scottalmond/EletronicEgg/README.md

# EletronicEgg
No-mess eletronic solution to the classical egg drop contest

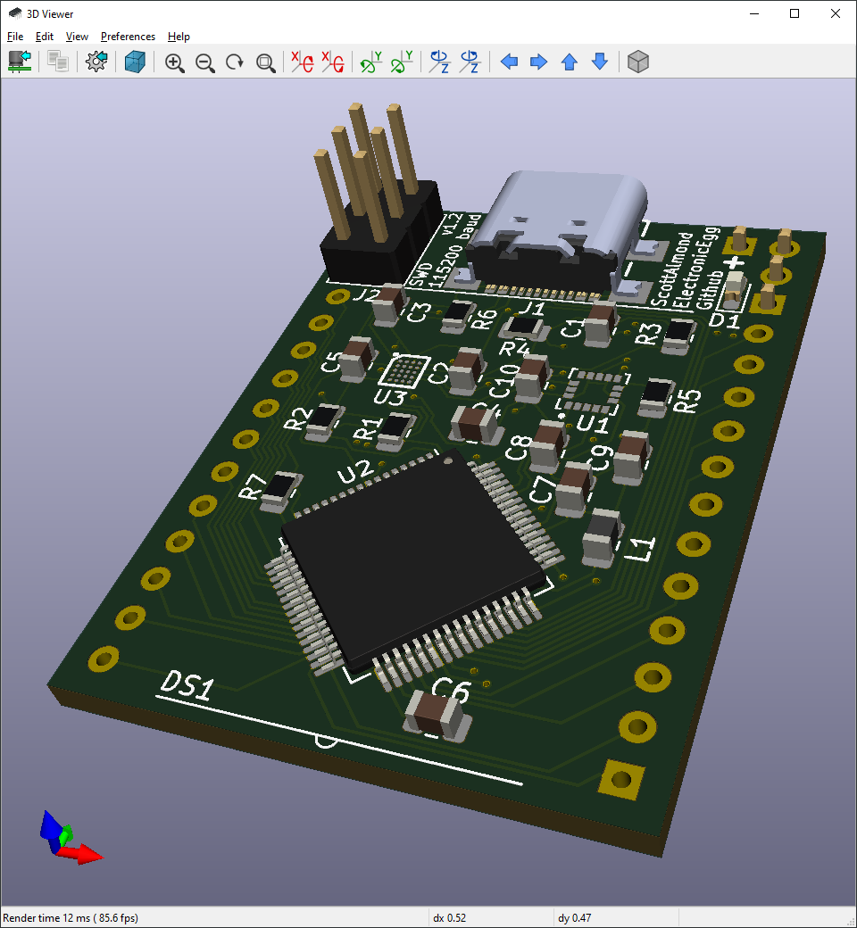
[picture p1: pcb/draft_1-2/png/3d_orthographic_front.png]
v1.1 Build
