scottalmond/EletronicEgg/pcb/draft_1-1/fab_notes.txt

set to 6mil spacing (default to 8)
set min hole size to 0.3mm since there was no impact on cost

as built list:
https://www.youtube.com/watch?v=ENmDnoKs2hM
plus F and B paste layers
$22.97 including shipping and PayPal fee

-- 1/6/20
as-delivered
width of 3-segment display is wrong, will need to bend all leads to fit
IS 22.86 mm (0.9")
***SHOULD BE just under 1.00" 

require stand-alone programming pins
https://www.avdweb.nl/arduino/samd21/samd21-programmer
***SHOULD BE ICE header
- pull-up on SWCLK pin 1k (10k?) [has internal pull-up at start-up per page 88 of SAML21 foc, 15.6.2]
https://learn.adafruit.com/programming-an-m0-using-an-arduino
- 100k on SWDIO https://www.microchip.com/webdoc/GUID-B2CE0E6C-70BF-42CF-B0CF-6705800FC877/index.html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

***consider through-hole 10k thermistor
***add /MR reset to allow toggle of 18.8V rail

1/12/19 lots of issues determining how to program SAML21 vs the ATTINY85 in the last project
need special debugger, beware educaton license limitations.  Was assuming everything could be done over USB - but only true after first flash

solder stencil tutorial https://www.meatandnetworking.com/tutorials/creating-svg-files-worth-of-creating-solder-stencils-from-kicad/

voltera stencil
https://www.voltera.io/docs/export/kicad/

***add compressed air and flux to parts list

***typo on "electronic" missing 'c'

- 1/16/20

need BOM print out for CCA fab, part placement
0402 heats up quickly during rework (bkth ends of part)
desire refactot with 0805 since 0402 are challenging to work with
not all parts (0805) lie perfectly flat
issue with gettting solder out of voltera for larger pcb pads (hot/dry solder?)
observe short (?) under usb header
PMIC has no bond (solder reflow point is higher than default Votera temperature)
reworked other issues by hand (incomplete passive bonding, SAML lead bridging)

- 1/17/20
***1.8V and 3.3V are shorted
***add test point for every voltage, i2c

***add place for debug led (no-pop in final model?)
