scottalmond/EletronicEgg/pcb/mockup_1-0/sketch.pdf

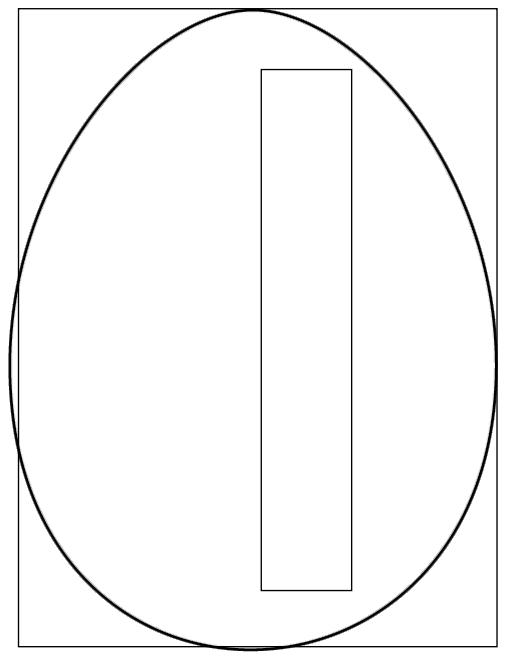
[picture p2: figure]
