scottalmond/EletronicEgg/pcb/draft_1-1/pcb/draft_1.png

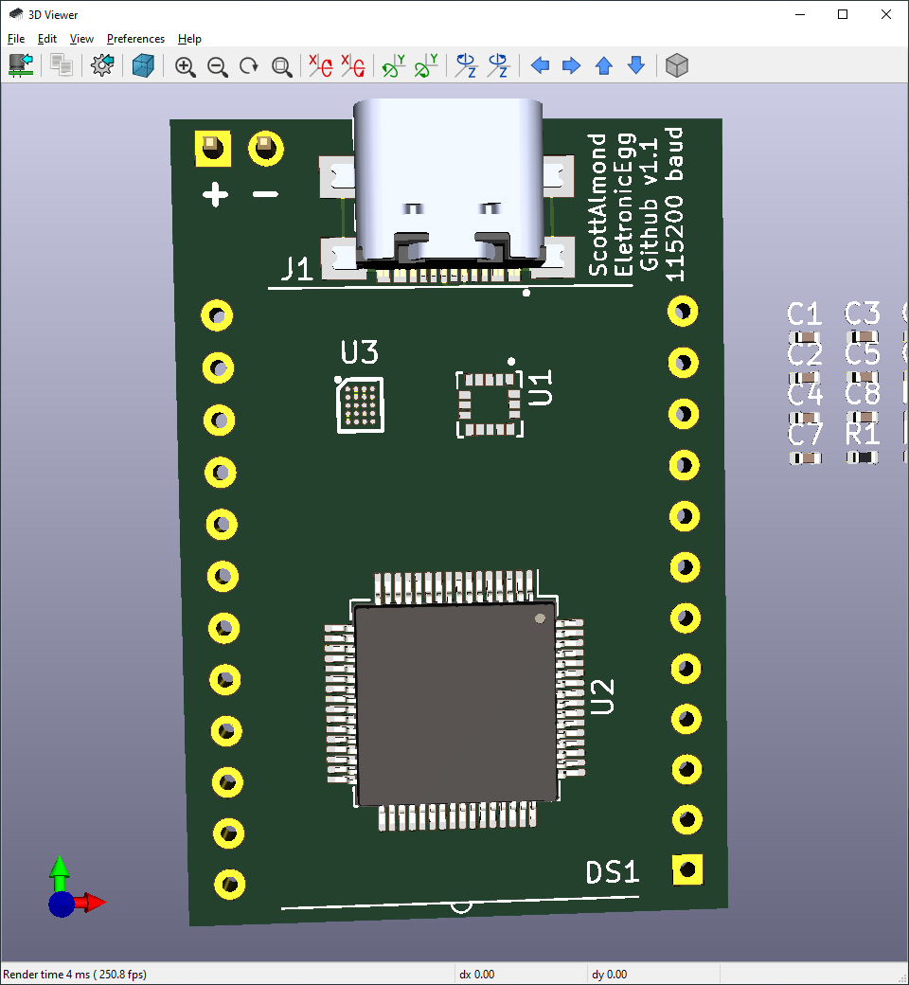
pcb/draft_1-1/pcb/draft_1.png
