scottalmond/EletronicEgg/pcb/draft_1-1/pcb/draft_1_sch.png

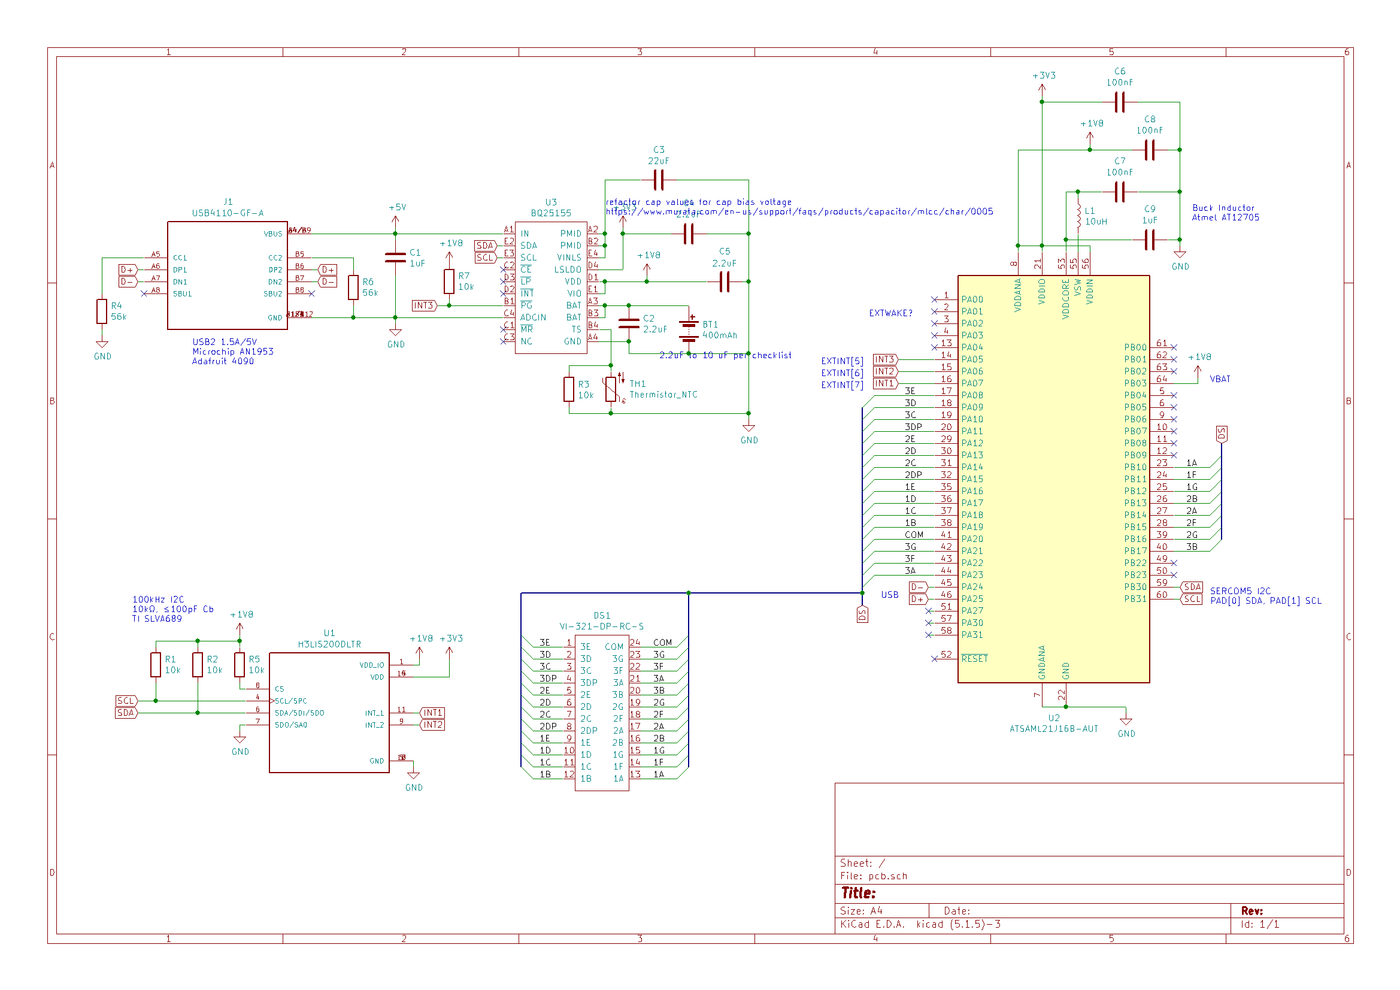
pcb/draft_1-1/pcb/draft_1_sch.png
