scottalmond/EletronicEgg/pcb/draft_1-1/png/001.png

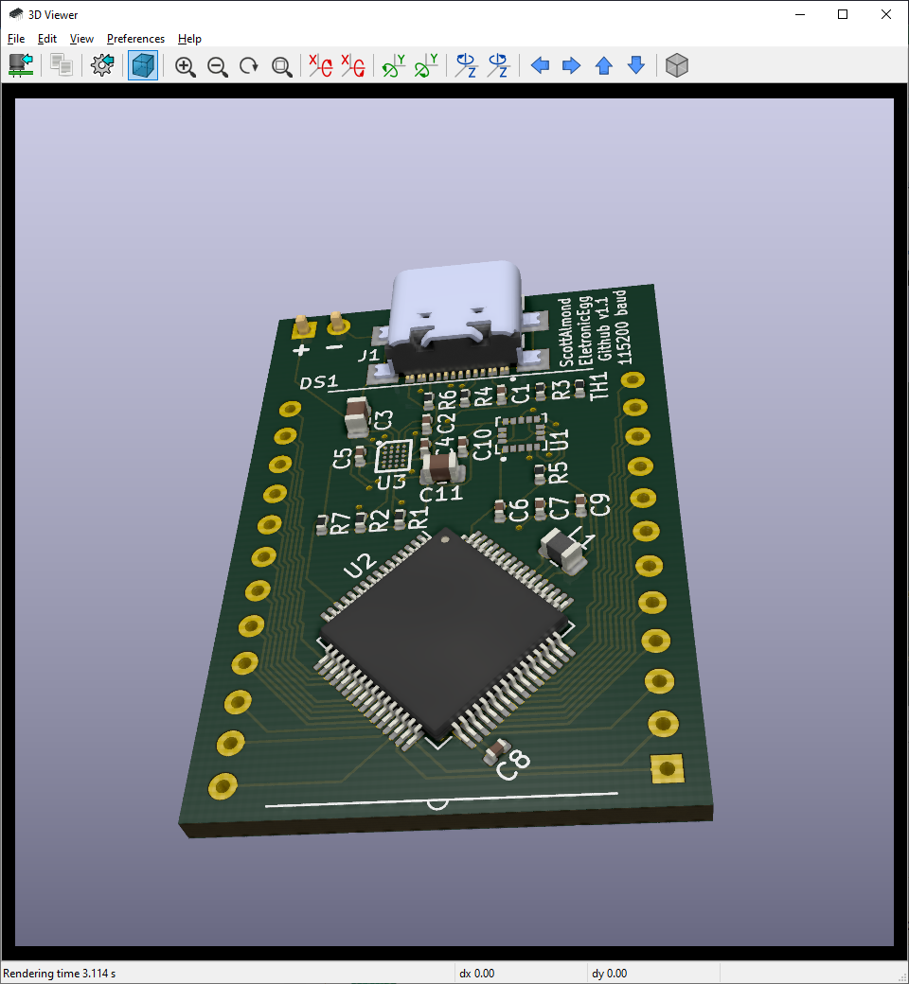
pcb/draft_1-1/png/001.png
