scottalmond/EletronicEgg/pcb/draft_1-1/png/002.png

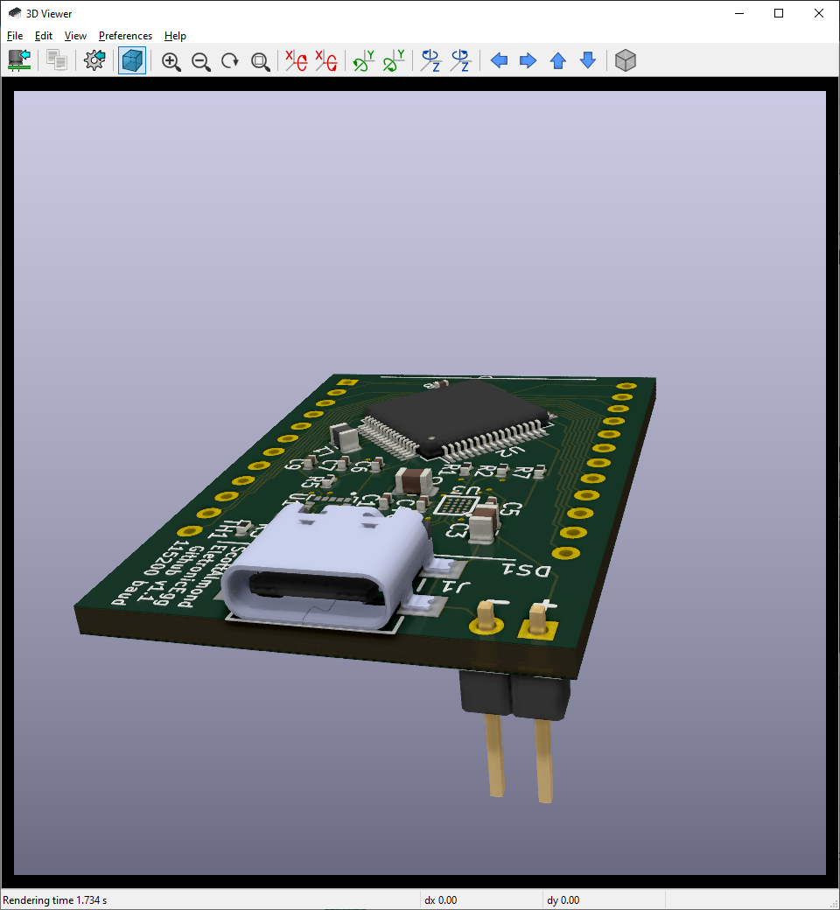
pcb/draft_1-1/png/002.png
