scottalmond/EletronicEgg/pcb/draft_1-1/png/back.png

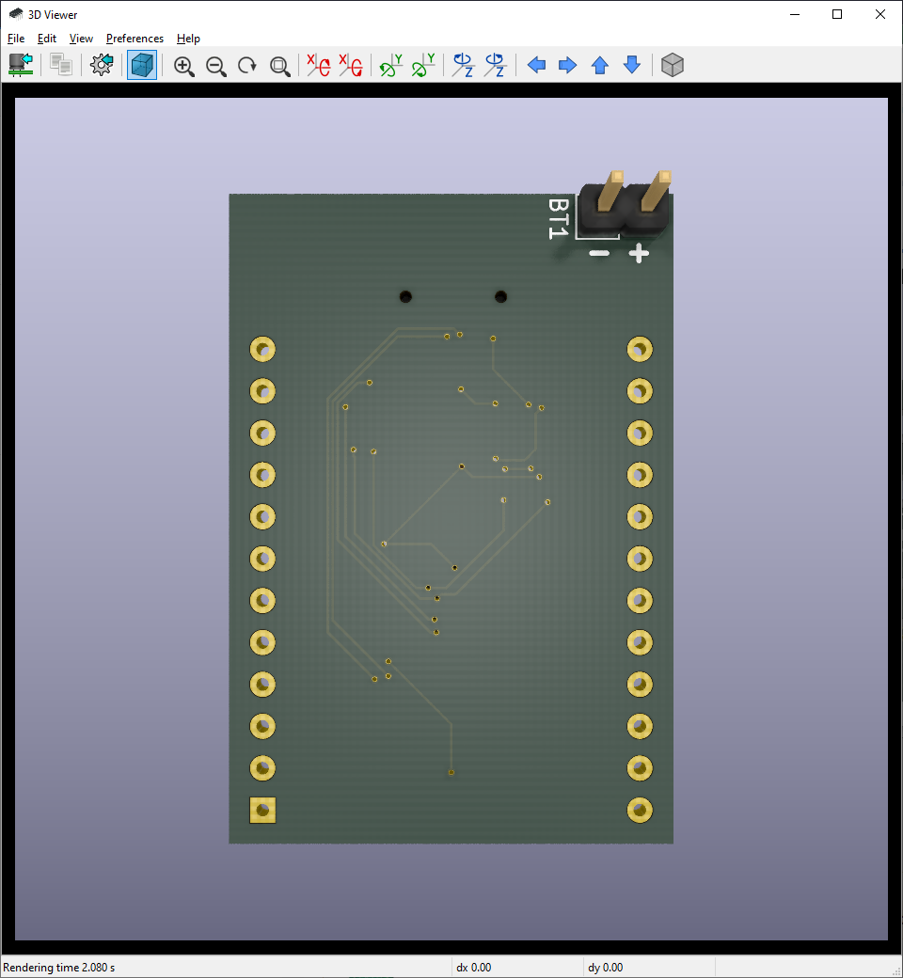
pcb/draft_1-1/png/back.png
