scottalmond/EletronicEgg/pcb/draft_1-1/png/pcbnew.png

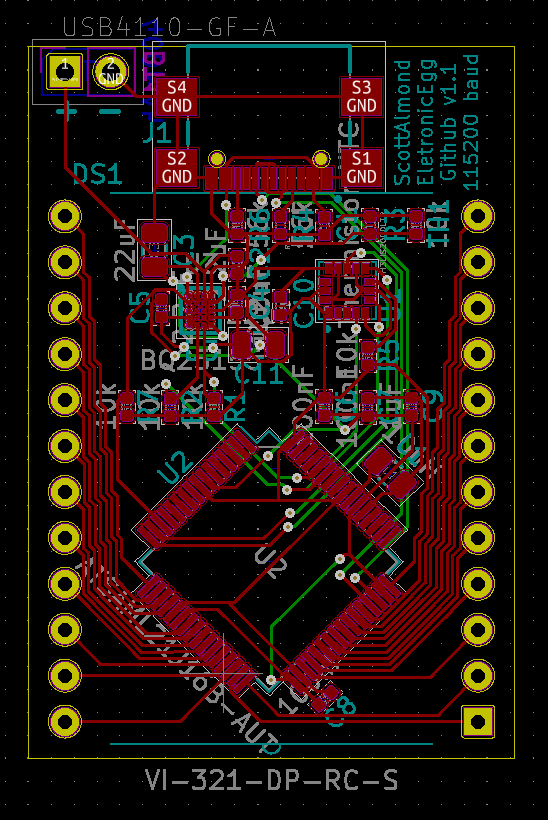
pcb/draft_1-1/png/pcbnew.png
