scottalmond/EletronicEgg/pcb/draft_1-1/png/schematic.png

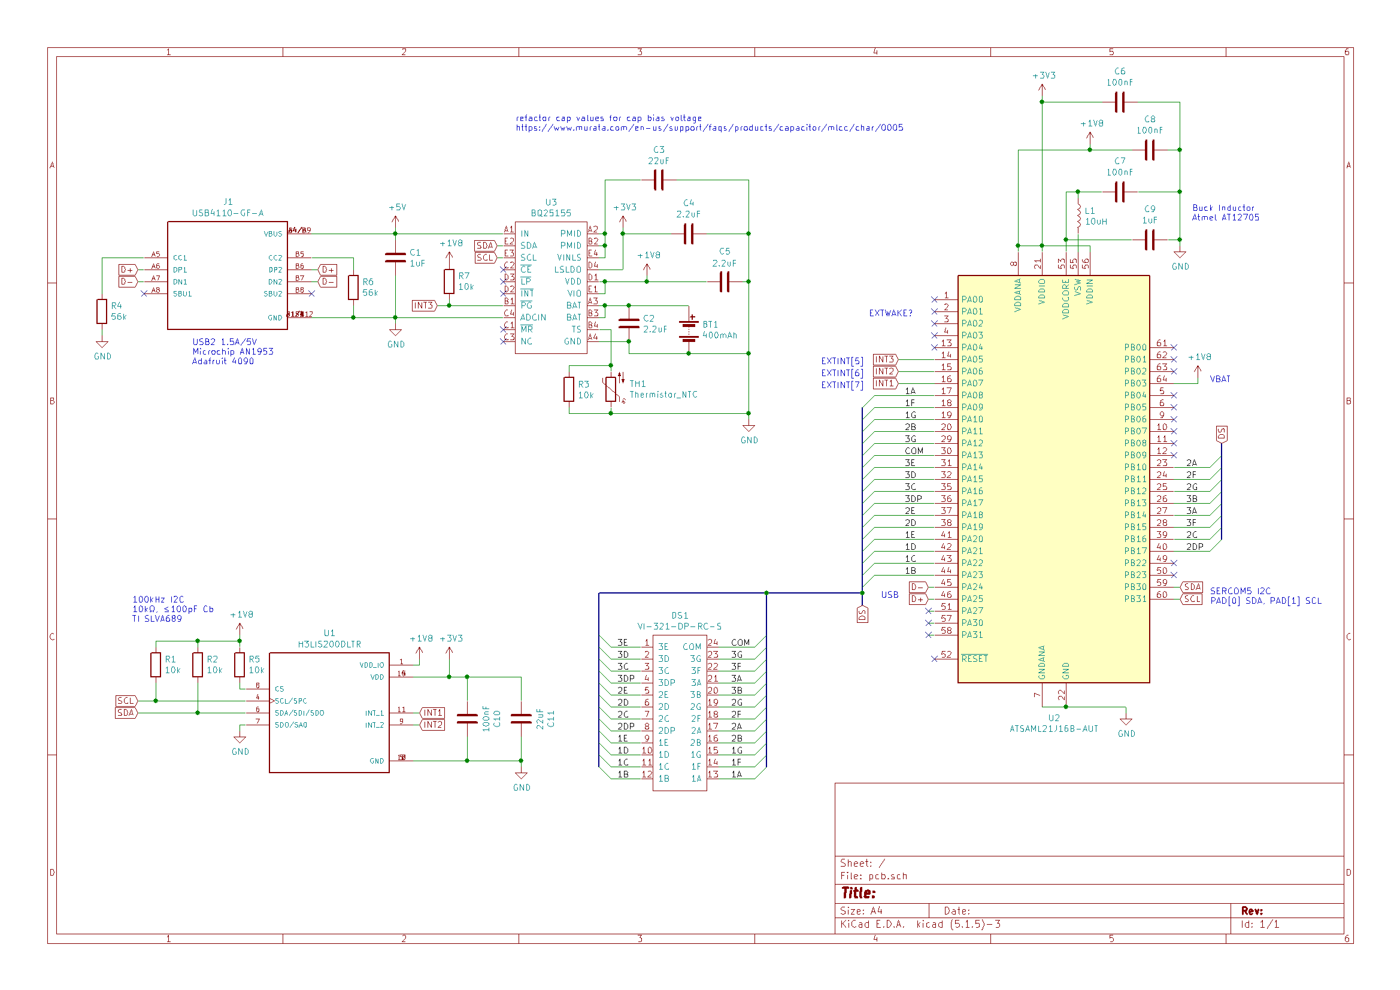
pcb/draft_1-1/png/schematic.png
