scottalmond/EletronicEgg/pcb/draft_1-1/png/top.png

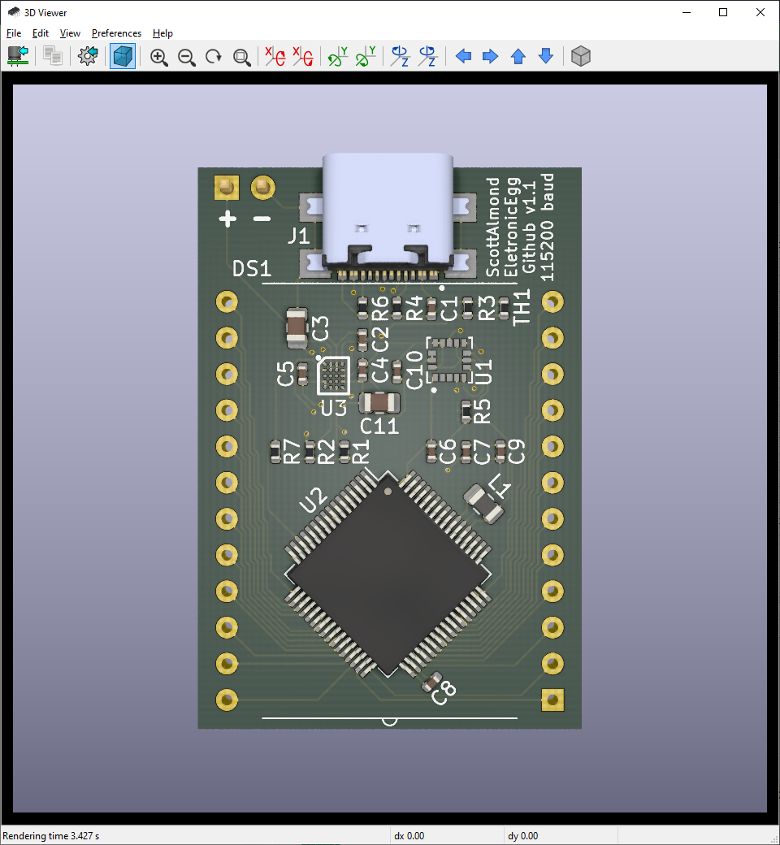
pcb/draft_1-1/png/top.png
