scottalmond/EletronicEgg/pcb/draft_1-2/png/3d_back.png

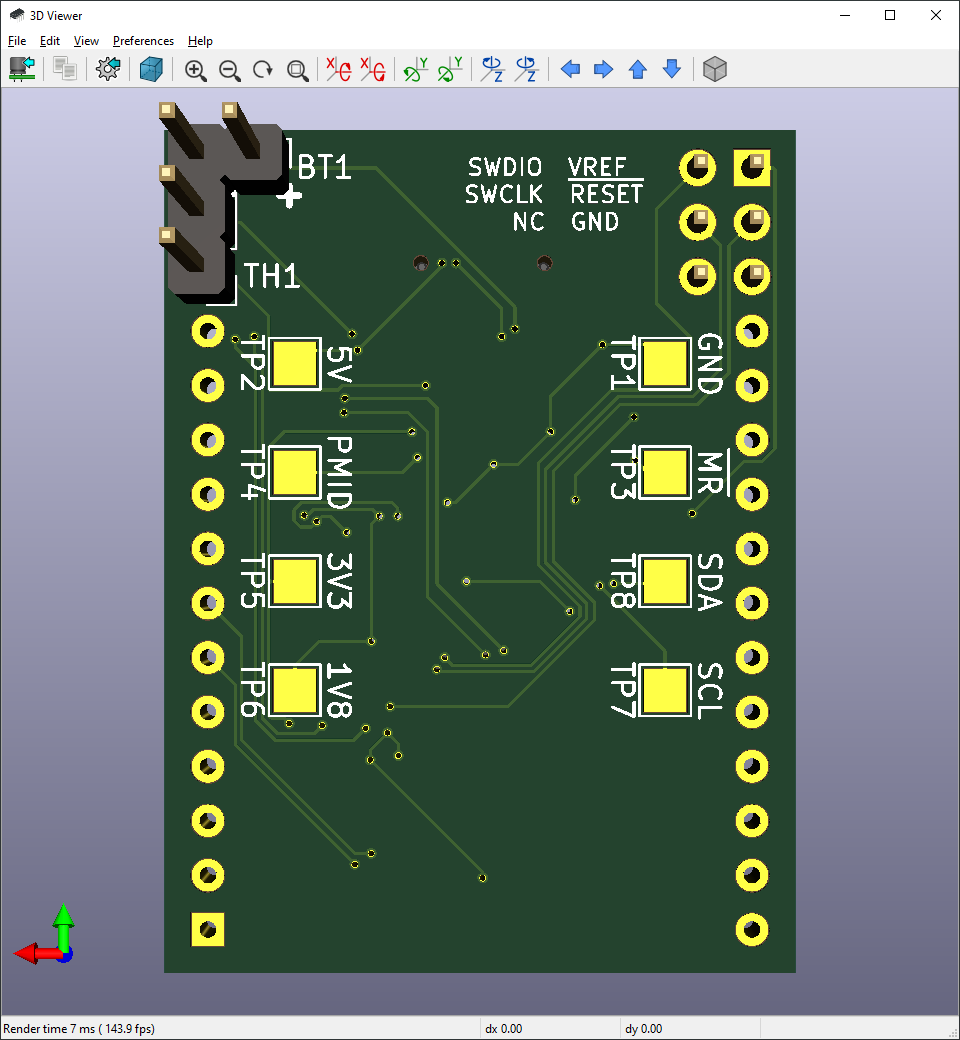
pcb/draft_1-2/png/3d_back.png
