scottalmond/EletronicEgg/pcb/draft_1-2/png/3d_front.png

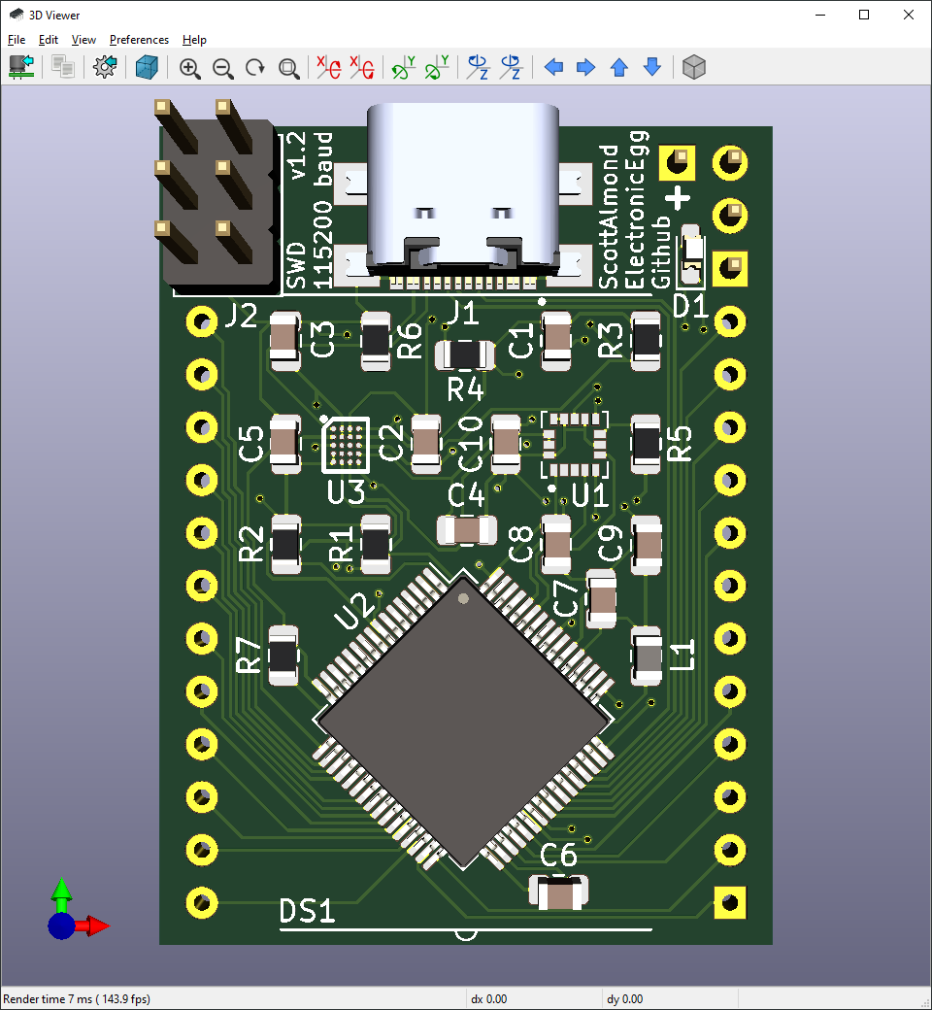
pcb/draft_1-2/png/3d_front.png
