scottalmond/EletronicEgg/pcb/draft_1-2/png/3d_orthographic_back.png

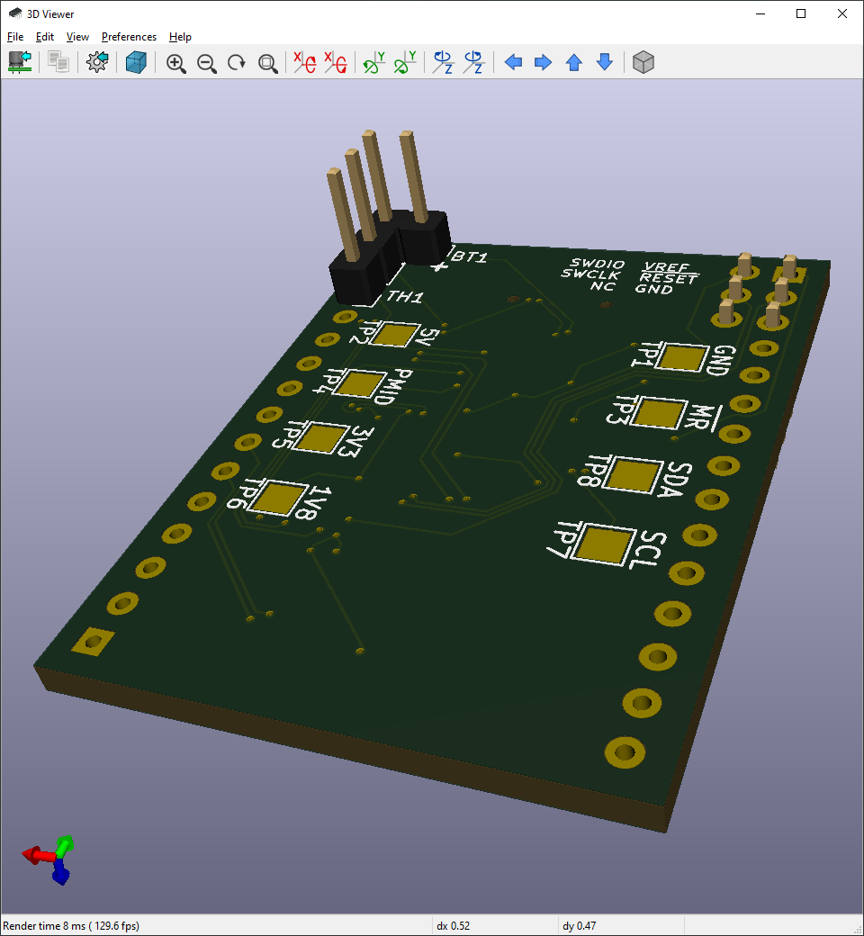
pcb/draft_1-2/png/3d_orthographic_back.png
