scottalmond/EletronicEgg/pcb/draft_1-2/png/pcb.png

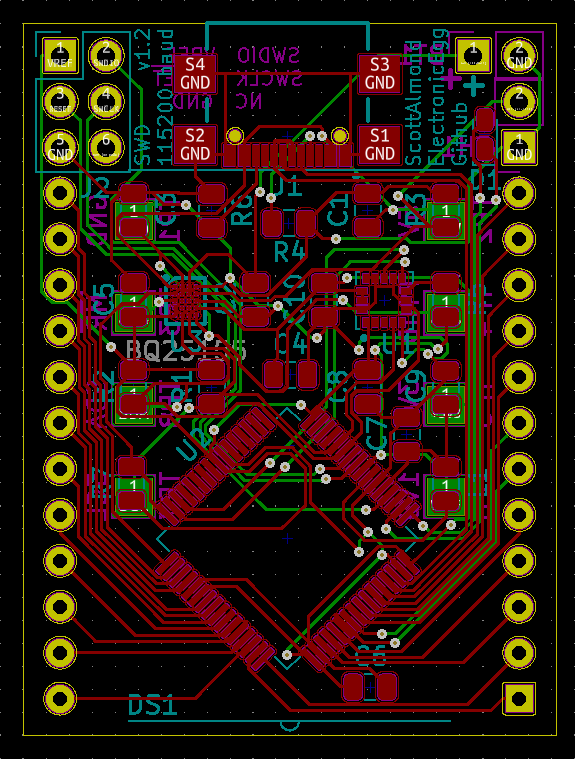
pcb/draft_1-2/png/pcb.png
