scottalmond/EletronicEgg/pcb/draft_1-2/png/schematic.png

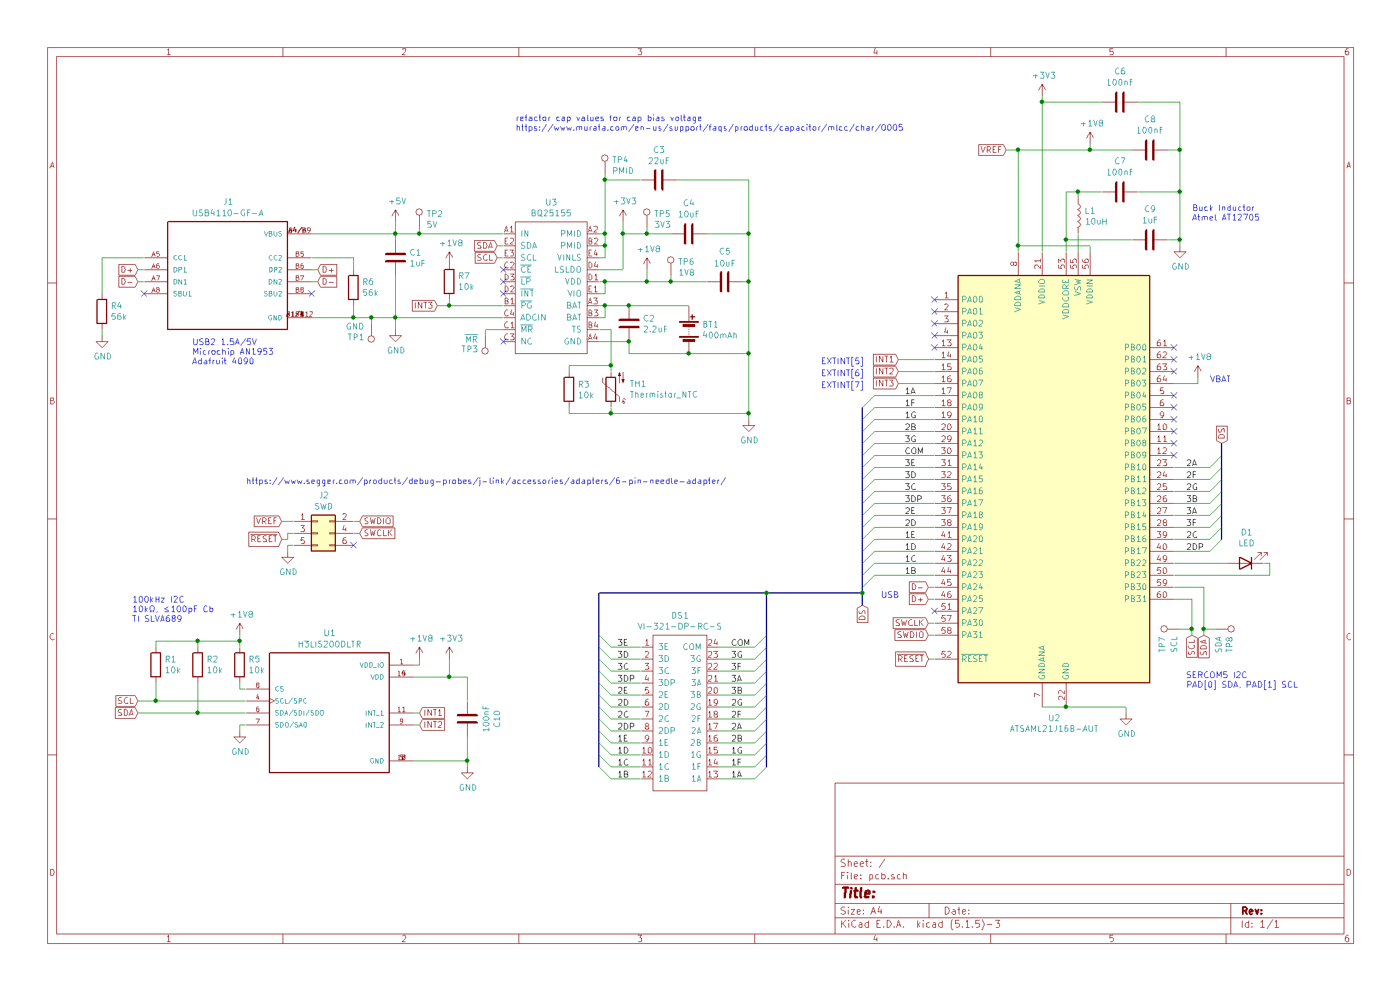
pcb/draft_1-2/png/schematic.png
