scottalmond/EletronicEgg/pcb/mockup_1-0/sketch.svg.png

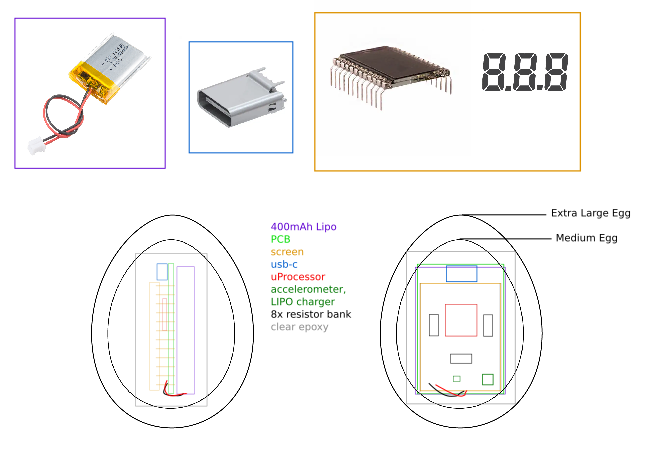
pcb/mockup_1-0/sketch.svg.png
