scottalmond/EletronicEgg/pcb/draft_1-1/BOM.xlsx

System Qty: | 10 |  |  |  |  | Price/quantity |  |  |  |  |  |  |  |  | price per |  |  |  |  |  |  |  | ext price
Cost/System | $41.48
Description | Name | Component Qty/System | Component Qty to Order | Link | Alternate Link | 1 | 5 | 10 | 25 | 50 | 100 | 500 | 1000 |  | 1 | 5 | 10 | 25 | 50 | 100 | 500 | 1000 | 1 | 5 | 10 | 25 | 50 | 100 | 500 | 1000 | best value
400 mAh Battery | PRT-13851 | 1 | 10 | https://www.digikey.com/product-detail/en/sparkfun-electronics/PRT-13851/1568-1493-ND/6605199 | https://www.sparkfun.com/products/13851 | 4.95 |  |  |  |  |  |  |  | 10 | 4.95 | 4.95 | 4.95 | 4.95 | 4.95 | 4.95 | 4.95 | 4.95 | 4.95 | 4.95 | 4.95 | 12.375 | 24.75 | 49.5 | 247.5 | 495 | 4.95
3 segment screen | VI-321-DP-RC-S | 1 | 10 | https://www.digikey.com/product-detail/en/varitronix/VI-321-DP-RC-S/153-1101-ND/531266 |  | 6.3 |  | 5.25 |  |  | 3.68 | 3.045 | 2.793 | 10 | 6.3 | 6.3 | 5.25 | 5.25 | 5.25 | 3.68 | 3.045 | 2.793 | 6.3 | 6.3 | 5.25 | 13.125 | 26.25 | 36.8 | 152.25 | 279.3 | 5.25
USB header | USB4110-GF-A | 1 | 10 | https://www.digikey.com/product-detail/en/gct/USB4110-GF-A/2073-USB4110-GF-A-1-ND/10384548 |  | 1.37 |  | 1.25 | 1.69 | 1.12 | 1.067 | 0.88936 |  | 10 | 1.37 | 1.37 | 1.25 | 1.69 | 1.12 | 1.067 | 0.88936 | 0.88936 | 1.37 | 1.37 | 1.25 | 4.225 | 5.6 | 10.67 | 44.468 | 88.936 | 1.25
200g accel | H3LIS200DLTR | 1 | 10 | https://www.digikey.com/product-detail/en/stmicroelectronics/H3LIS200DLTR/497-15698-1-ND/5267984 |  | 7.34 |  | 6.63 | 6.34 |  | 5.49 | 4.78252 | 4.16543 | 10 | 7.34 | 7.34 | 6.63 | 6.34 | 6.34 | 5.49 | 4.78252 | 4.16543 | 7.34 | 7.34 | 6.63 | 15.85 | 31.7 | 54.9 | 239.126 | 416.543 | 6.63
SAML21J | ATSAML21J16B-AUT | 1 | 10 | https://www.digikey.com/product-detail/en/microchip-technology/ATSAML21J16B-AUT/ATSAML21J16B-AUTCT-ND/5702310 |  | 3.32 |  |  | 3.02 |  | 2.73 |  |  | 10 | 3.32 | 3.32 | 3.32 | 3.02 | 3.02 | 2.73 | 2.73 | 2.73 | 3.32 | 3.32 | 3.32 | 7.55 | 15.1 | 27.3 | 136.5 | 273 | 3.32
PMIC/LDO | BQ25155YFPT | 1 | 10 | https://www.digikey.com/product-detail/en/texas-instruments/BQ25155YFPT/296-BQ25155YFPTCT-ND/10435202 |  | 3.31 |  | 2.98 | 2.81 |  | 2.31 |  |  | 10 | 3.31 | 3.31 | 2.98 | 2.81 | 2.81 | 2.31 | 2.31 | 2.31 | 3.31 | 3.31 | 2.98 | 7.025 | 14.05 | 23.1 | 115.5 | 231 | 2.98
1 uF 0402 | CC0402KRX5R5BB105 | 2 | 10 | https://www.digikey.com/product-detail/en/yageo/CC0402KRX5R5BB105/311-1438-1-ND/2833744 |  | 0.1 |  | 0.047 |  |  | 0.021 | 0.01502 | 0.0118 | 20 | 0.1 | 0.1 | 0.047 | 0.047 | 0.047 | 0.021 | 0.01502 | 0.0118 | 0.2 | 0.2 | 0.094 | 0.1175 | 0.235 | 0.21 | 0.751 | 1.18 | 0.094
2.2uF 0402 | GRM155R61A225KE95D | 3 | 25 | https://www.digikey.com/product-detail/en/murata-electronics/GRM155R61A225KE95D/490-10451-1-ND/5026361 |  | 0.12 |  | 0.088 |  |  | 0.0414 | 0.029 | 0.0205 | 30 | 0.12 | 0.12 | 0.088 | 0.088 | 0.088 | 0.0414 | 0.029 | 0.0205 | 0.36 | 0.36 | 0.264 | 0.264 | 0.44 | 0.414 | 1.45 | 2.05 | 0.264
22 uF 0805 | CL21A226MQQNNNE | 2 | 10 | https://www.digikey.com/product-detail/en/samsung-electro-mechanics/CL21A226MQQNNNE/1276-1100-1-ND/3889186 |  | 0.18 |  | 0.121 |  |  | 0.061 | 0.04204 | 0.03719 | 20 | 0.18 | 0.18 | 0.121 | 0.121 | 0.121 | 0.061 | 0.04204 | 0.03719 | 0.36 | 0.36 | 0.242 | 0.3025 | 0.605 | 0.61 | 2.102 | 3.719 | 0.242
100 nF 0402 | CL05B104KO5NNNC | 4 | 25 | https://www.digikey.com/product-detail/en/samsung-electro-mechanics/CL05B104KO5NNNC/1276-1001-1-ND/3889087 |  | 0.1 |  | 0.024 |  |  | 0.011 | 0.00766 | 0.00602 | 40 | 0.1 | 0.1 | 0.024 | 0.024 | 0.024 | 0.011 | 0.00766 | 0.00602 | 0.4 | 0.4 | 0.096 | 0.096 | 0.12 | 0.11 | 0.383 | 0.602 | 0.096
10 uH 0805 | LBR2012T100K | 1 | 10 | https://www.digikey.com/product-detail/en/taiyo-yuden/LBR2012T100K/587-2045-1-ND/1788992 |  | 0.14 |  | 0.13 |  |  | 0.086 | 0.07188 | 0.06038 | 10 | 0.14 | 0.14 | 0.13 | 0.13 | 0.13 | 0.086 | 0.07188 | 0.06038 | 0.14 | 0.14 | 0.13 | 0.325 | 0.65 | 0.86 | 3.594 | 6.038 | 0.13
10k 0402 | RC0402FR-0710KL | 5 | 100 | https://www.digikey.com/product-detail/en/yageo/RC0402FR-0710KL/311-10.0KLRCT-ND/729470 |  | 0.1 |  | 0.016 |  |  | 0.0064 |  | 0.00289 | 50 | 0.1 | 0.1 | 0.016 | 0.016 | 0.016 | 0.0064 | 0.0064 | 0.00289 | 0.5 | 0.5 | 0.08 | 0.08 | 0.08 | 0.064 | 0.32 | 0.289 | 0.064
56k 0402 | RC0402FR-0756KL | 2 | 10 | https://www.digikey.com/product-detail/en/yageo/RC0402FR-0756KL/311-56.0KLRCT-ND/729582 |  | 0.1 |  | 0.016 |  |  | 0.0064 |  | 0.00289 | 20 | 0.1 | 0.1 | 0.016 | 0.016 | 0.016 | 0.0064 | 0.0064 | 0.00289 | 0.2 | 0.2 | 0.032 | 0.04 | 0.08 | 0.064 | 0.32 | 0.289 | 0.032
10k Thermistor 0402 | NCP15XH103F03RC | 1 | 10 | https://www.digikey.com/product-detail/en/murata-electronics/NCP15XH103F03RC/490-4801-1-ND/1644682 |  | 0.14 | 0.134 | 0.12 | 0.11 | 0.08 | 0.076 | 0.0663 | 0.05683 | 10 | 0.14 | 0.134 | 0.12 | 0.11 | 0.08 | 0.076 | 0.0663 | 0.05683 | 0.14 | 0.134 | 0.12 | 0.275 | 0.4 | 0.76 | 3.315 | 5.683 | 0.12
PCB | AllPCB 27 * 40 mm | 1 | 10 | https://www.allpcb.com/online_pcb_quote.html |  | 5 | 1 | 0.7 | 0.32 | 0.28 | 0.17 |  |  | 10 | 5 | 1 | 0.7 | 0.32 | 0.28 | 0.17 | 0.17 | 0.17 | 5 | 1 | 0.7 | 0.8 | 1.4 | 1.7 | 8.5 | 17 | 0.7
PCBA | 100 SMT, 11 BOM | 1 | 10 | https://www.allpcb.com/pcba_quote.html |  | 88.31 | 17.662 | 9.338 | 4.0544 | 3.1272 | 2.52 |  |  | 10 | 88.31 | 17.662 | 9.338 | 4.0544 | 3.1272 | 2.52 | 2.52 | 2.52 | 88.31 | 17.662 | 9.338 | 10.136 | 15.636 | 25.2 | 126 | 252 | 9.338
Resin | 2 oz/egg | 1 | 10 | https://www.mcmaster.com/8644K58 |  | 35.71 | 7.142 | 3.571 |  |  |  |  |  | 10 | 35.71 | 7.142 | 3.571 | 3.571 | 3.571 | 3.571 | 3.571 | 3.571 | 35.71 | 7.142 | 3.571 | 8.9275 | 17.855 | 35.71 | 178.55 | 357.1 | 3.571
Silicone | 8595K14 | 1 | 10 | https://www.mcmaster.com/8595K14 | https://www.mcmaster.com/8595K15 | 14.34 | 2.868 | 1.586 |  |  |  |  |  | 10 | 14.34 | 2.868 | 1.586 | 1.586 | 1.586 | 1.586 | 1.586 | 1.586 | 14.34 | 2.868 | 1.586 | 3.965 | 7.93 | 15.86 | 79.3 | 158.6 | 1.586
Mold release | 1409K52 | 1 | 10 | https://www.mcmaster.com/1409K52 |  | 8.67 | 1.734 | 0.867 | 0.6936 | 0.867 | 0.867 |  |  | 10 | 8.67 | 1.734 | 0.867 | 0.6936 | 0.867 | 0.867 | 0.867 | 0.867 | 8.67 | 1.734 | 0.867 | 1.734 | 4.335 | 8.67 | 43.35 | 86.7 | 0.867
 |  |  |  |  |  |  |  |  |  |  |  |  |  |  |  |  |  |  |  |  |  |  |  |  |  |  |  |  |  |  | 41.484
 |  |  |  |  |  |  |  |  |  |  |  |  |  |  |  |  | 1 | 180.83
 |  |  |  |  |  |  |  |  |  |  |  |  |  |  |  |  | 5 | 58.201
 |  |  |  |  |  |  |  |  |  |  |  |  |  |  |  |  | 10 | 41.6285
 |  |  |  |  |  |  |  |  |  |  |  |  |  |  |  |  | 15 | 38.54833333
 |  |  |  |  |  |  |  |  |  |  |  |  |  |  |  |  | 20 | 36.64
 |  |  |  |  |  |  |  |  |  |  |  |  |  |  |  |  | 25 | 34.5146
 |  |  |  |  |  |  |  |  |  |  |  |  |  |  |  |  | 30 | 34.44833333
 |  |  |  |  |  |  |  |  |  |  |  |  |  |  |  |  | 35 | 34.41128571
 |  |  |  |  |  |  |  |  |  |  |  |  |  |  |  |  | 40 | 34.2461
 |  |  |  |  |  |  |  |  |  |  |  |  |  |  |  |  | 45 | 33.7786
 |  |  |  |  |  |  |  |  |  |  |  |  |  |  |  |  | 50 | 33.2606
 |  |  |  |  |  |  |  |  |  |  |  |  |  |  |  |  | 55 | 33.2606
 |  |  |  |  |  |  |  |  |  |  |  |  |  |  |  |  | 60 | 33.2606
 |  |  |  |  |  |  |  |  |  |  |  |  |  |  |  |  | 65 | 33.24213846
 |  |  |  |  |  |  |  |  |  |  |  |  |  |  |  |  | 70 | 33.21631429
 |  |  |  |  |  |  |  |  |  |  |  |  |  |  |  |  | 75 | 32.8486
 |  |  |  |  |  |  |  |  |  |  |  |  |  |  |  |  | 80 | 32.5206
 |  |  |  |  |  |  |  |  |  |  |  |  |  |  |  |  | 85 | 31.97634118
 |  |  |  |  |  |  |  |  |  |  |  |  |  |  |  |  | 90 | 31.1634 |  |  | 10 | ~40
 |  |  |  |  |  |  |  |  |  |  |  |  |  |  |  |  | 95 | 30.18182105 |  |  | 25 | ~35
 |  |  |  |  |  |  |  |  |  |  |  |  |  |  |  |  | 100 | 29.2293 |  |  | 100 | ~30
