scottalmond/EletronicEgg/pcb/draft_1-1/gerbers/as_fabricated_settings.png

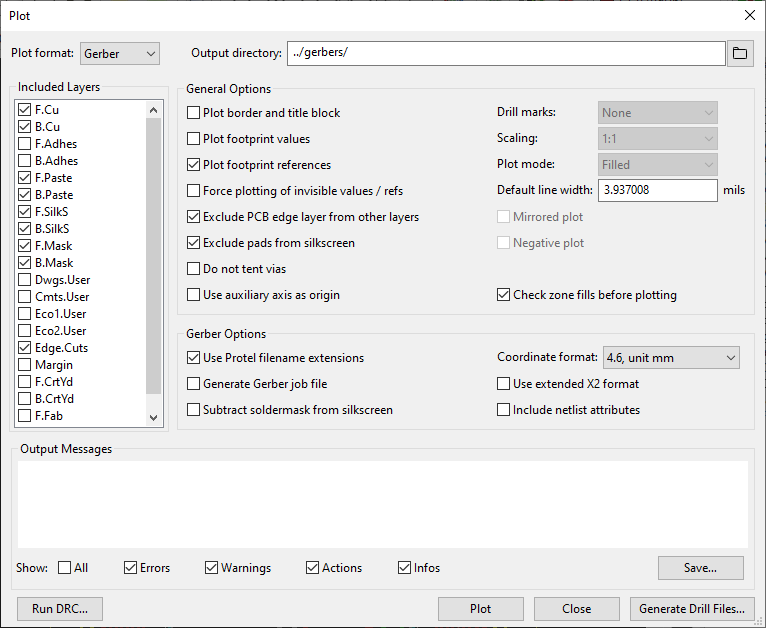
pcb/draft_1-1/gerbers/as_fabricated_settings.png
