scottalmond/EletronicEgg/pcb/draft_1-1/stencil/pcb-F_Paste_outline.pdf

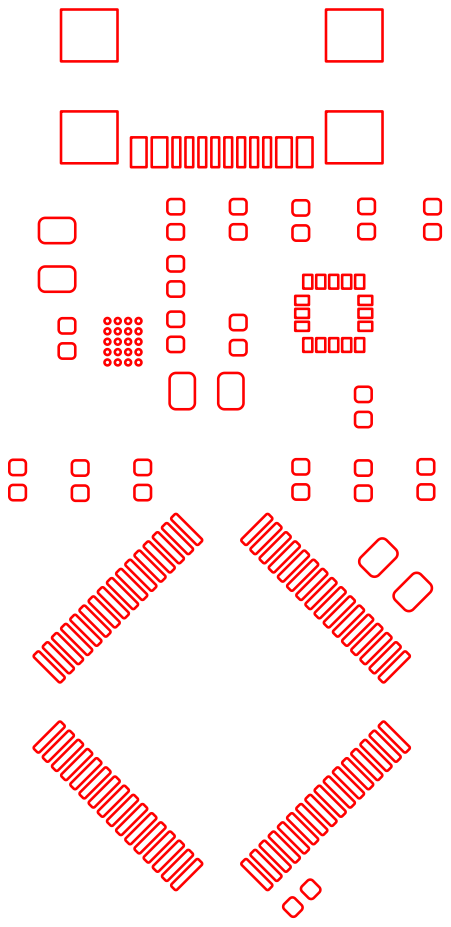
[picture p18: page 1]
