scottalmond/EletronicEgg/doc/spec_sheets/archive/LCD-S301C31TR_3segmentDisplay.pdf

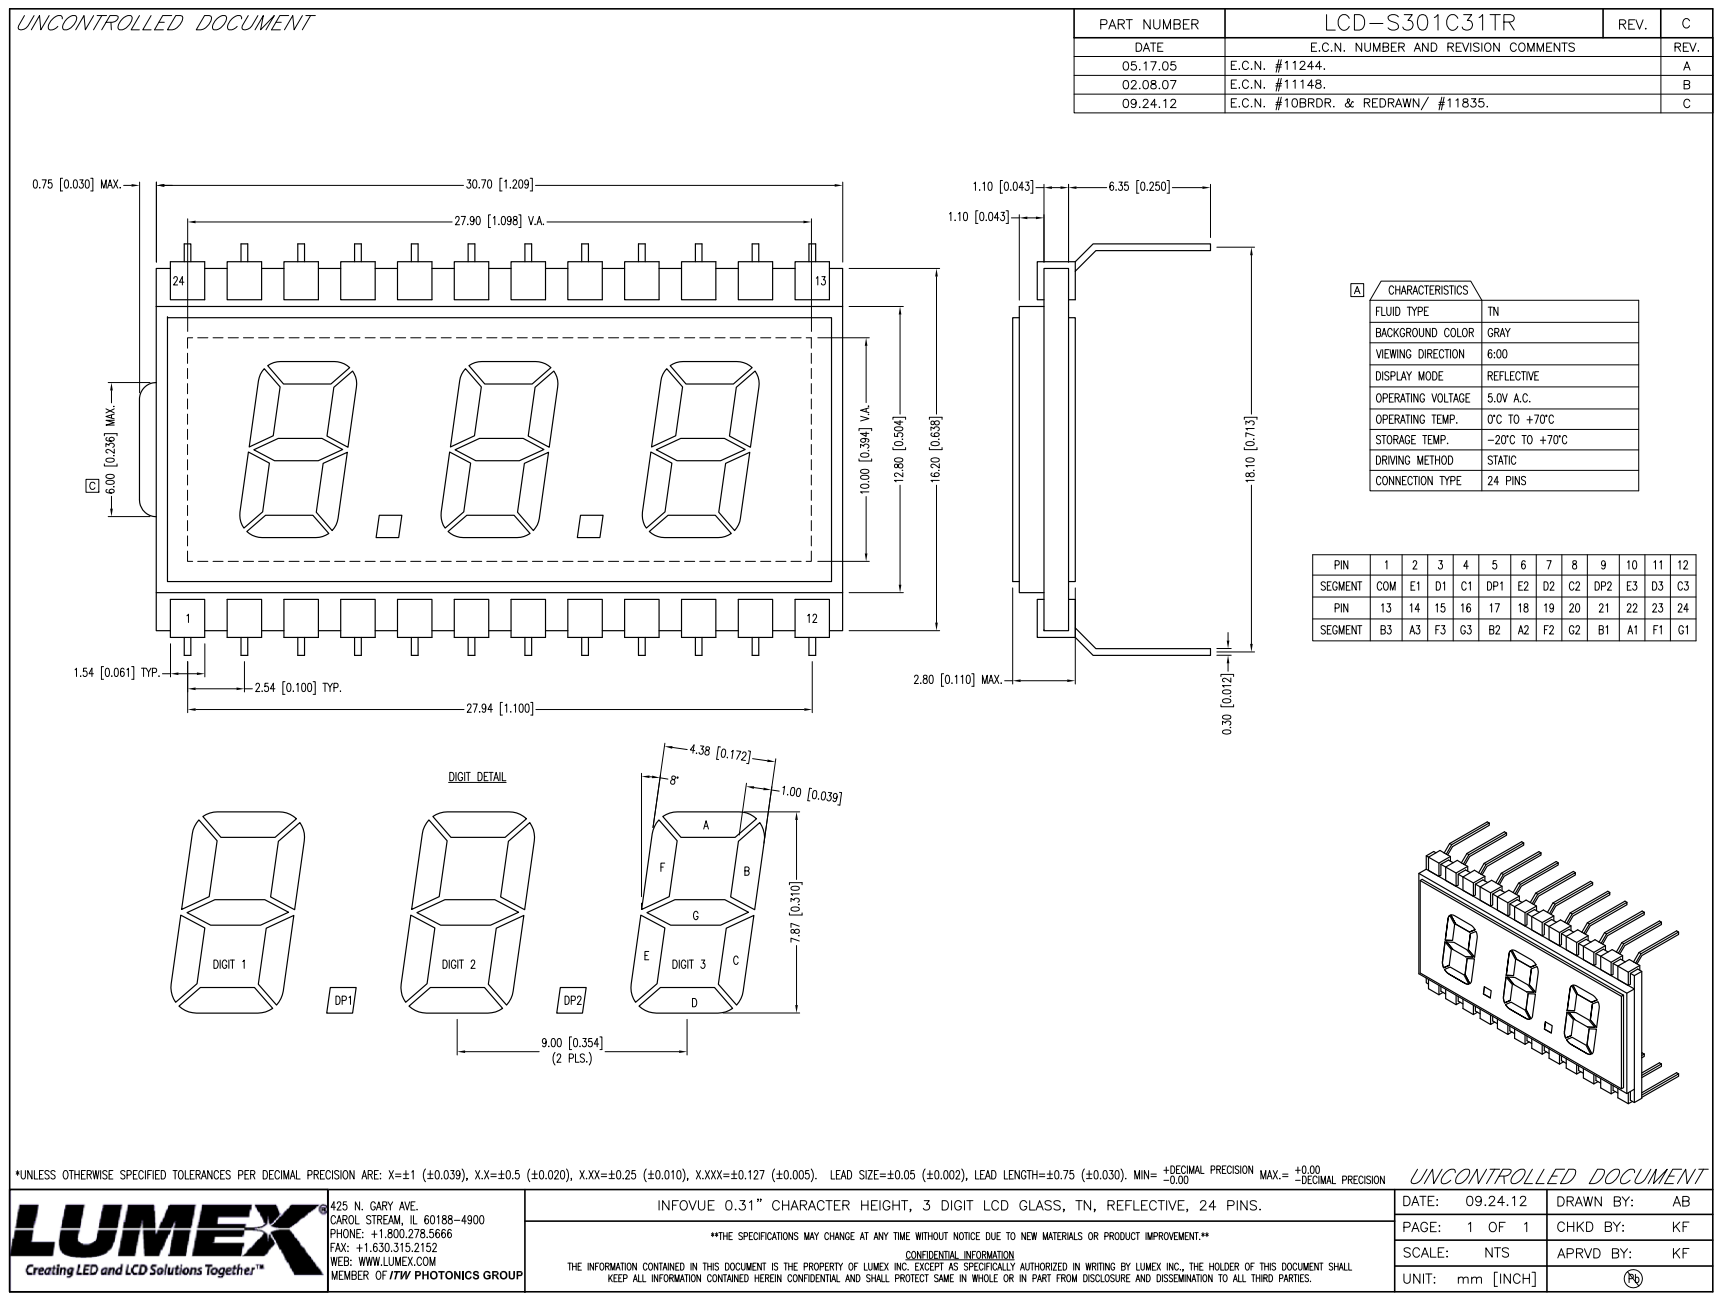
[picture p19: page 1]
