scottalmond/EletronicEgg/pcb/draft_1-2/pcb/pcb.kicad_pcb

## KiCad design pcb/draft_1-2/pcb/pcb.kicad_pcb (2020-02-07)

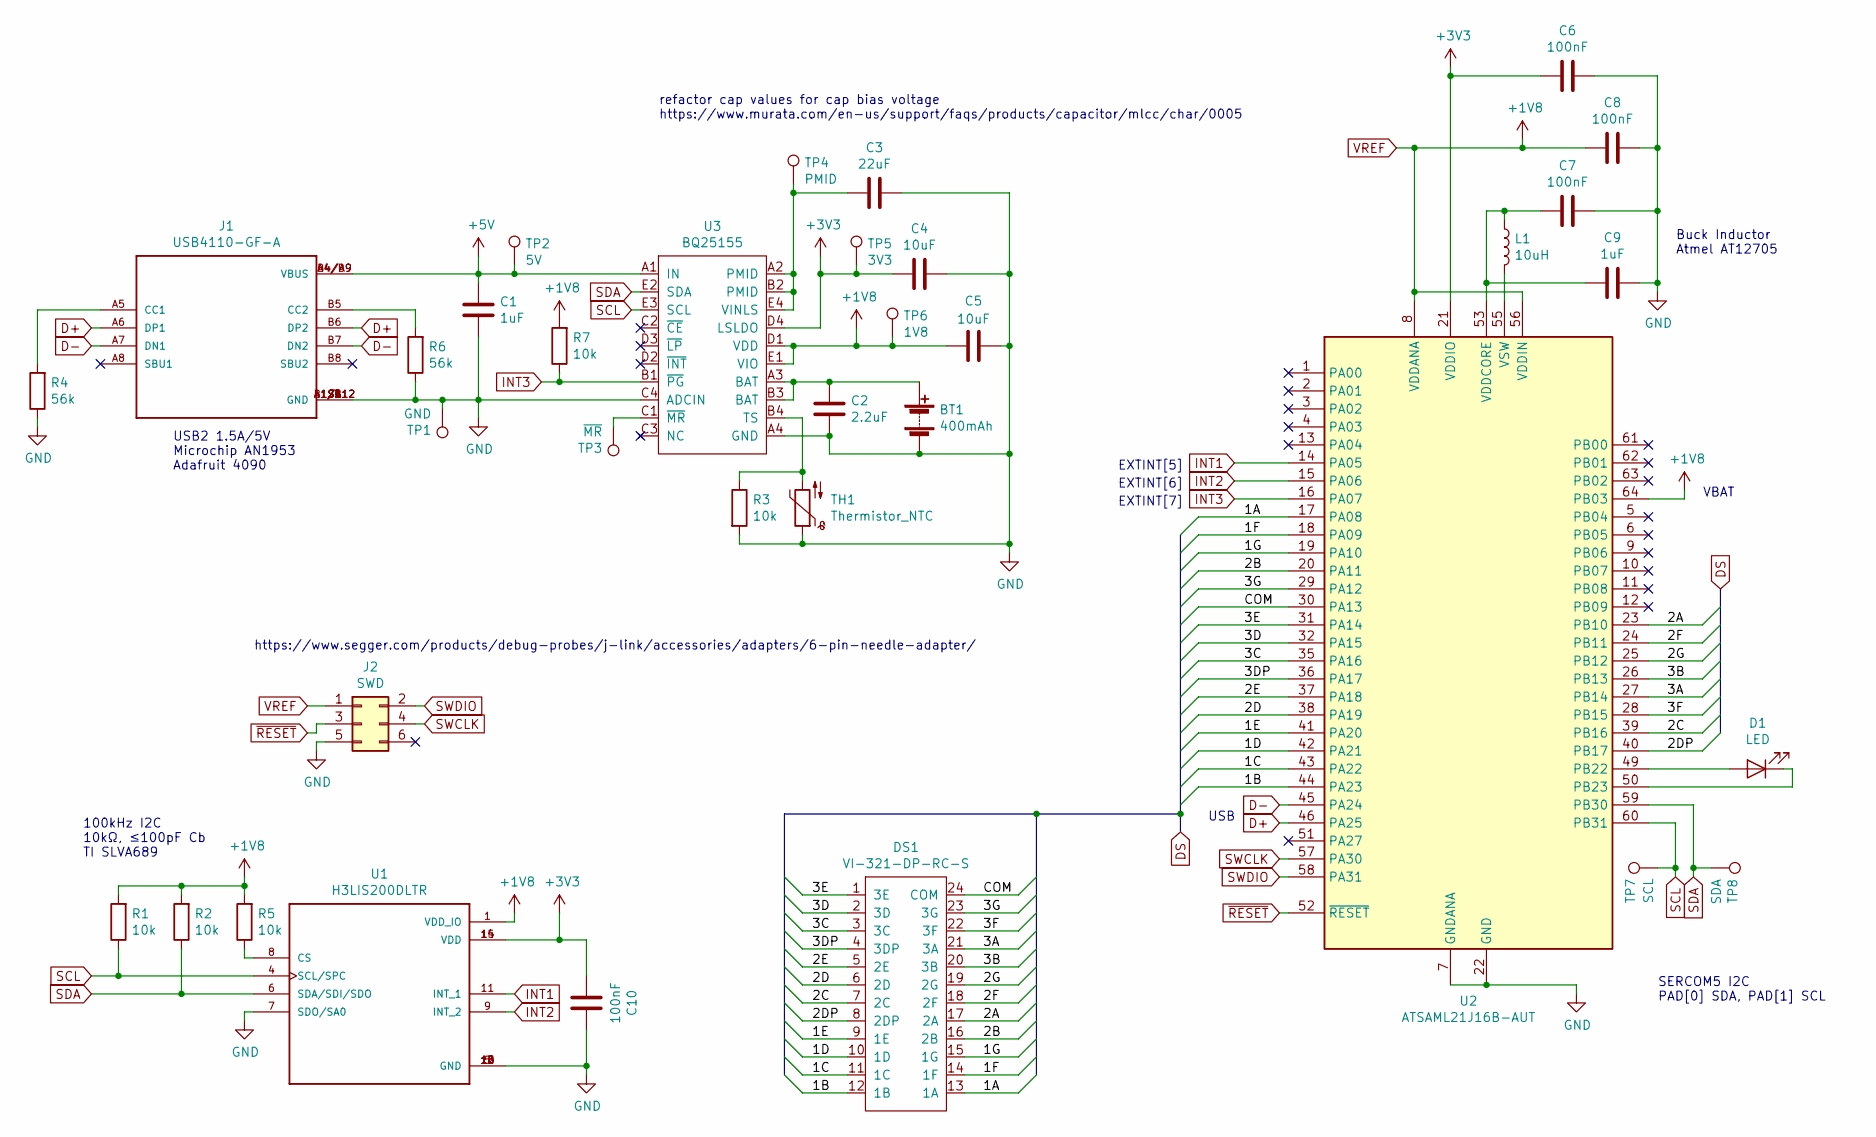
[picture p20: schematic pcb.sch]

Parts:
BT1: 400mAh; PinHeader_1x02_P2.54mm_Vertical
C1, C9: 1uF; C_0805_2012Metric
C2: 2.2uF; C_0805_2012Metric
C3: 22uF; C_0805_2012Metric
C4, C5: 10uF; C_0805_2012Metric
C6, C7, C8, C10: 100nF; C_0805_2012Metric
D1: LED; LED_0603_1608Metric_Castellated
DS1: VI-321-DP-RC-S
J1: USB4110-GF-A; GCT_USB4110-GF-A
J2: SWD; PinHeader_2x03_P2.54mm_Vertical
L1: 10uH; L_0805_2012Metric
R1, R2, R3, R5, R7: 10k; R_0805_2012Metric
R4, R6: 56k; R_0805_2012Metric
TH1: Thermistor_NTC; PinHeader_1x02_P2.54mm_Vertical
TP1: GND; TestPoint_Pad_2.0x2.0mm
TP2: 5V; TestPoint_Pad_2.0x2.0mm
TP3: ~MR; TestPoint_Pad_2.0x2.0mm
TP4: PMID; TestPoint_Pad_2.0x2.0mm
TP5: 3V3; TestPoint_Pad_2.0x2.0mm
TP6: 1V8; TestPoint_Pad_2.0x2.0mm
TP7: SCL; TestPoint_Pad_2.0x2.0mm
TP8: SDA; TestPoint_Pad_2.0x2.0mm
U1: H3LIS200DLTR; PQFN50P300X300X100-16N
U2: ATSAML21J16B-AUT; TQFP-64_10x10mm_P0.5mm
U3: BQ25155; BGA20C40P4X5_162X202X50

Connections:
+3V3: C4.1, C6.1, C10.2, TP5.1, U1.14 (VDD), U1.15 (VDD), U2.21 (VDDIO), U2.34 (VDDIO), U2.48 (VDDIO), U3.D4 (LSLDO)
+5V: C1.1, J1.A4/B9 (VBUS), J1.B4/A9 (VBUS), TP2.1, U3.A1 (IN)
/1A: DS1.13 (1A), U2.17 (PA08)
/1B: DS1.12 (1B), U2.44 (PA23)
/1C: DS1.11 (1C), U2.43 (PA22)
/1D: DS1.10 (1D), U2.42 (PA21)
/1E: DS1.9 (1E), U2.41 (PA20)
/1F: DS1.14 (1F), U2.18 (PA09)
/1G: DS1.15 (1G), U2.19 (PA10)
/2A: DS1.17 (2A), U2.23 (PB10)
/2B: DS1.16 (2B), U2.20 (PA11)
/2C: DS1.7 (2C), U2.39 (PB16)
/2D: DS1.6 (2D), U2.38 (PA19)
/2DP: DS1.8 (2DP), U2.40 (PB17)
/2E: DS1.5 (2E), U2.37 (PA18)
/2F: DS1.18 (2F), U2.24 (PB11)
/2G: DS1.19 (2G), U2.25 (PB12)
/3A: DS1.21 (3A), U2.27 (PB14)
/3B: DS1.20 (3B), U2.26 (PB13)
/3C: DS1.3 (3C), U2.35 (PA16)
/3D: DS1.2 (3D), U2.32 (PA15)
/3DP: DS1.4 (3DP), U2.36 (PA17)
/3E: DS1.1 (3E), U2.31 (PA14)
/3F: DS1.22 (3F), U2.28 (PB15)
/3G: DS1.23 (3G), U2.29 (PA12)
/COM: DS1.24 (COM), U2.30 (PA13)
D+: J1.A6 (DP1), J1.B6 (DP2), U2.46 (PA25)
D-: J1.A7 (DN1), J1.B7 (DN2), U2.45 (PA24)
GND: BT1.2 (-), C1.2, C2.2, C3.1, C4.2, C5.2, C6.2, C7.2, C8.2, C9.2, C10.1, J1.A1/B12 (GND), J1.B1/A12 (GND), J1.S1 (GND), J1.S2 (GND), J1.S3 (GND), J1.S4 (GND), J2.5, R3.2, R4.1, R6.1, TH1.1, TP1.1, U1.5 (GND), U1.7 (SDO/SA0), U1.10 (GND), U1.12 (GND), U1.13 (GND), U1.16 (GND), U2.7 (GNDANA), U2.22 (GND), U2.33 (GND), U2.47 (GND), U2.54 (GND), U3.A4 (GND), U3.C4 (ADCIN)
INT1: U1.11 (INT_1), U2.14 (PA05)
INT2: U1.9 (INT_2), U2.15 (PA06)
INT3: R7.1, U2.16 (PA07), U3.B1 (~PG)
unnamed: BT1.1 (+), C2.1, U3.A3 (BAT), U3.B3 (BAT)
unnamed: C3.2, TP4.1, U3.A2 (PMID), U3.B2 (PMID), U3.E4 (VINLS)
unnamed: C7.1, C9.1, L1.1, U2.53 (VDDCORE)
unnamed: D1.1 (K), U2.50 (PB23)
unnamed: D1.2 (A), U2.49 (PB22)
unnamed: J1.A5 (CC1), R4.2
unnamed: J1.B5 (CC2), R6.2
unnamed: L1.2, U2.55 (VSW)
unnamed: R3.1, TH1.2, U3.B4 (TS)
unnamed: R5.1, U1.8 (CS)
unnamed: TP3.1, U3.C1 (~MR)
SCL: R1.1, TP7.1, U1.4 (SCL/SPC), U2.60 (PB31), U3.E3 (SCL)
SDA: R2.1, TP8.1, U1.6 (SDA/SDI/SDO), U2.59 (PB30), U3.E2 (SDA)
SWCLK: J2.4, U2.57 (PA30)
SWDIO: J2.2, U2.58 (PA31)
VREF: C5.1, C8.1, J2.1, R1.2, R2.2, R5.2, R7.2, TP6.1, U1.1 (VDD_IO), U2.8 (VDDANA), U2.56 (VDDIN), U2.64 (PB03), U3.D1 (VDD), U3.E1 (VIO)
~RESET: J2.3, U2.52 (~RESET)

Notes on the sheet:
refactor cap values for cap bias voltage https://www.murata.com/en-us/support/faqs/products/capacitor/mlcc/char/0005
USB2 1.5A/5V Microchip AN1953 Adafruit 4090
USB
SERCOM5 I2C PAD[0] SDA, PAD[1] SCL
EXTINT[5]
EXTINT[6]
EXTINT[7]
100kHz I2C 10kΩ, ≤100pF Cb TI SLVA689
VBAT
Buck Inductor Atmel AT12705
https://www.segger.com/products/debug-probes/j-link/accessories/adapters/6-pin-needle-adapter/

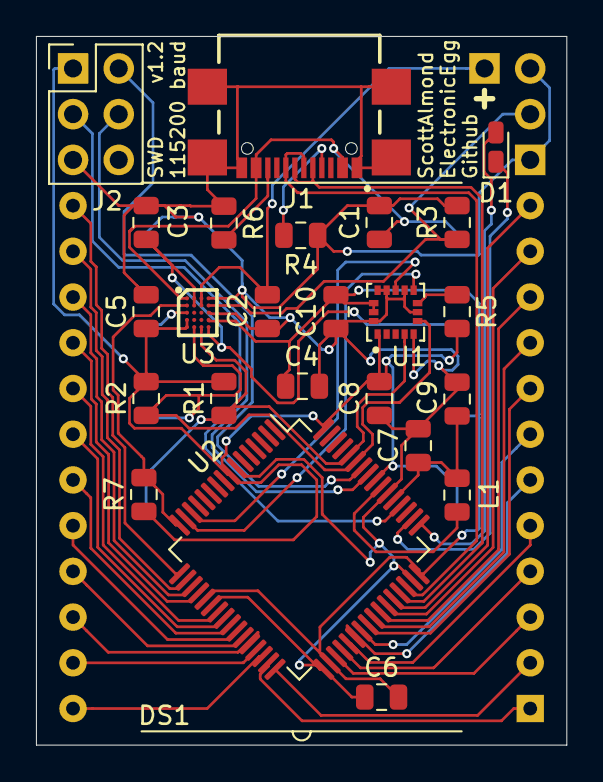
[picture p21: board pcb.kicad_pcb from above]

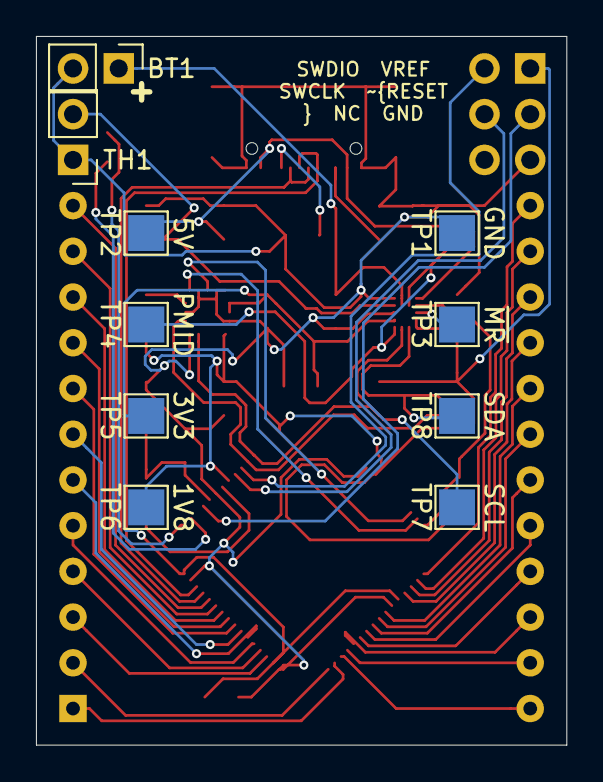
[picture p22: board pcb.kicad_pcb from below]

Board: 2 copper layers, 29.5 x 39.4 mm, 35 parts (10 on the bottom side), 49 nets.
