scottalmond/EletronicEgg/src/test/i2c_test3/i2c_test3/atmel_start_pins.h

/*
 * Code generated from Atmel Start.
 *
 * This file will be overwritten when reconfiguring your Atmel Start project.
 * Please copy examples or other code you want to keep to a separate file
 * to avoid losing it when reconfiguring.
 */
#ifndef ATMEL_START_PINS_H_INCLUDED
#define ATMEL_START_PINS_H_INCLUDED

#include <hal_gpio.h>

// SAML21 has 9 pin functions

#define GPIO_PIN_FUNCTION_A 0
#define GPIO_PIN_FUNCTION_B 1
#define GPIO_PIN_FUNCTION_C 2
#define GPIO_PIN_FUNCTION_D 3
#define GPIO_PIN_FUNCTION_E 4
#define GPIO_PIN_FUNCTION_F 5
#define GPIO_PIN_FUNCTION_G 6
#define GPIO_PIN_FUNCTION_H 7
#define GPIO_PIN_FUNCTION_I 8

#define PA05 GPIO(GPIO_PORTA, 5)
#define PA06 GPIO(GPIO_PORTA, 6)
#define PA07 GPIO(GPIO_PORTA, 7)
#define DS_1A GPIO(GPIO_PORTA, 8)
#define DS_1F GPIO(GPIO_PORTA, 9)
#define DS_1G GPIO(GPIO_PORTA, 10)
#define LED_P GPIO(GPIO_PORTB, 22)
#define LED_N GPIO(GPIO_PORTB, 23)
#define PB30 GPIO(GPIO_PORTB, 30)
#define PB31 GPIO(GPIO_PORTB, 31)

#endif // ATMEL_START_PINS_H_INCLUDED
