scottalmond/EletronicEgg/src/test/i2c_test3/i2c_test3/driver_init.c

/*
 * Code generated from Atmel Start.
 *
 * This file will be overwritten when reconfiguring your Atmel Start project.
 * Please copy examples or other code you want to keep to a separate file
 * to avoid losing it when reconfiguring.
 */

#include "driver_init.h"
#include <peripheral_clk_config.h>
#include <utils.h>
#include <hal_init.h>

struct i2c_m_sync_desc I2C_0;

void EXTERNAL_IRQ_0_init(void)
{
	hri_gclk_write_PCHCTRL_reg(GCLK, EIC_GCLK_ID, CONF_GCLK_EIC_SRC | (1 << GCLK_PCHCTRL_CHEN_Pos));
	hri_mclk_set_APBAMASK_EIC_bit(MCLK);

	// Set pin direction to input
	gpio_set_pin_direction(PA05, GPIO_DIRECTION_IN);

	gpio_set_pin_pull_mode(PA05,
	                       // <y> Pull configuration
	                       // <id> pad_pull_config
	                       // <GPIO_PULL_OFF"> Off
	                       // <GPIO_PULL_UP"> Pull-up
	                       // <GPIO_PULL_DOWN"> Pull-down
	                       GPIO_PULL_OFF);

	gpio_set_pin_function(PA05, PINMUX_PA05A_EIC_EXTINT5);

	// Set pin direction to input
	gpio_set_pin_direction(PA06, GPIO_DIRECTION_IN);

	gpio_set_pin_pull_mode(PA06,
	                       // <y> Pull configuration
	                       // <id> pad_pull_config
	                       // <GPIO_PULL_OFF"> Off
	                       // <GPIO_PULL_UP"> Pull-up
	                       // <GPIO_PULL_DOWN"> Pull-down
	                       GPIO_PULL_OFF);

	gpio_set_pin_function(PA06, PINMUX_PA06A_EIC_EXTINT6);

	// Set pin direction to input
	gpio_set_pin_direction(PA07, GPIO_DIRECTION_IN);

	gpio_set_pin_pull_mode(PA07,
	                       // <y> Pull configuration
	                       // <id> pad_pull_config
	                       // <GPIO_PULL_OFF"> Off
	                       // <GPIO_PULL_UP"> Pull-up
	                       // <GPIO_PULL_DOWN"> Pull-down
	                       GPIO_PULL_OFF);

	gpio_set_pin_function(PA07, PINMUX_PA07A_EIC_EXTINT7);

	ext_irq_init();
}

void I2C_0_PORT_init(void)
{

	gpio_set_pin_pull_mode(PB30,
	                       // <y> Pull configuration
	                       // <id> pad_pull_config
	                       // <GPIO_PULL_OFF"> Off
	                       // <GPIO_PULL_UP"> Pull-up
	                       // <GPIO_PULL_DOWN"> Pull-down
	                       GPIO_PULL_OFF);

	gpio_set_pin_function(PB30, PINMUX_PB30D_SERCOM5_PAD0);

	gpio_set_pin_pull_mode(PB31,
	                       // <y> Pull configuration
	                       // <id> pad_pull_config
	                       // <GPIO_PULL_OFF"> Off
	                       // <GPIO_PULL_UP"> Pull-up
	                       // <GPIO_PULL_DOWN"> Pull-down
	                       GPIO_PULL_OFF);

	gpio_set_pin_function(PB31, PINMUX_PB31D_SERCOM5_PAD1);
}

void I2C_0_CLOCK_init(void)
{
	hri_gclk_write_PCHCTRL_reg(GCLK, SERCOM5_GCLK_ID_CORE, CONF_GCLK_SERCOM5_CORE_SRC | (1 << GCLK_PCHCTRL_CHEN_Pos));
	hri_gclk_write_PCHCTRL_reg(GCLK, SERCOM5_GCLK_ID_SLOW, CONF_GCLK_SERCOM5_SLOW_SRC | (1 << GCLK_PCHCTRL_CHEN_Pos));

	hri_mclk_set_APBDMASK_SERCOM5_bit(MCLK);
}

void I2C_0_init(void)
{
	I2C_0_CLOCK_init();
	i2c_m_sync_init(&I2C_0, SERCOM5);
	I2C_0_PORT_init();
}

void system_init(void)
{
	init_mcu();

	// GPIO on PA08

	gpio_set_pin_level(DS_1A,
	                   // <y> Initial level
	                   // <id> pad_initial_level
	                   // <false"> Low
	                   // <true"> High
	                   false);

	// Set pin direction to output
	gpio_set_pin_direction(DS_1A, GPIO_DIRECTION_OUT);

	gpio_set_pin_function(DS_1A, GPIO_PIN_FUNCTION_OFF);

	// GPIO on PA09

	gpio_set_pin_level(DS_1F,
	                   // <y> Initial level
	                   // <id> pad_initial_level
	                   // <false"> Low
	                   // <true"> High
	                   false);

	// Set pin direction to output
	gpio_set_pin_direction(DS_1F, GPIO_DIRECTION_OUT);

	gpio_set_pin_function(DS_1F, GPIO_PIN_FUNCTION_OFF);

	// GPIO on PA10

	gpio_set_pin_level(DS_1G,
	                   // <y> Initial level
	                   // <id> pad_initial_level
	                   // <false"> Low
	                   // <true"> High
	                   false);

	// Set pin direction to output
	gpio_set_pin_direction(DS_1G, GPIO_DIRECTION_OUT);

	gpio_set_pin_function(DS_1G, GPIO_PIN_FUNCTION_OFF);

	// GPIO on PB22

	gpio_set_pin_level(LED_P,
	                   // <y> Initial level
	                   // <id> pad_initial_level
	                   // <false"> Low
	                   // <true"> High
	                   false);

	// Set pin direction to output
	gpio_set_pin_direction(LED_P, GPIO_DIRECTION_OUT);

	gpio_set_pin_function(LED_P, GPIO_PIN_FUNCTION_OFF);

	// GPIO on PB23

	gpio_set_pin_level(LED_N,
	                   // <y> Initial level
	                   // <id> pad_initial_level
	                   // <false"> Low
	                   // <true"> High
	                   false);

	// Set pin direction to output
	gpio_set_pin_direction(LED_N, GPIO_DIRECTION_OUT);

	gpio_set_pin_function(LED_N, GPIO_PIN_FUNCTION_OFF);

	EXTERNAL_IRQ_0_init();

	I2C_0_init();
}
