scottalmond/EletronicEgg/(commit log)

2019-12-31 schematic with SAML21G, will need to change to J for full pin compliement on 3.3V
    [pcb.kicad_pcb, pcb.sch]
2020-01-01 PRE-TRACE PLACEMENT CHECKPOINT
    [pcb.kicad_pcb, pcb.sch]
2020-01-03 attempt to route display
    [pcb.kicad_pcb, pcb.sch]
2020-01-03 bom cost estimate
    [BOM.csv, BOM.xlsx, pcb.kicad_pcb, pcb.sch]
2020-01-04 maximized squid traces
    [BOM.xlsx, pcb.kicad_pcb, pcb.sch]
2020-01-04 added accel decouple caps
    [pcb.kicad_pcb, pcb.sch]
2020-01-05 candidate layout done
    [BOM.xlsx, pcb.kicad_pcb, pcb.sch]
2020-01-05 as built
    [pcb-B_Cu.gbl, pcb-B_Mask.gbs, pcb-B_Paste.gbp, pcb-B_SilkS.gbo, pcb-Edge_Cuts.gm1, pcb-F_Cu.gtl, pcb-F_Mask.gts, pcb-F_Paste.gtp]
2020-01-10 bom cleanup
    [BOM.csv, BOM.xlsx]
2020-01-10 led blink test
2020-01-31 begin incorporating v1.2 changes
    [BOM.xlsx, pcb.kicad_pcb, pcb.sch]
2020-02-04 organized silk screen and swd tp
    [BOM.xlsx, pcb.sch]
2020-02-06 add example image to readme
    [pcb.kicad_pcb, pcb.sch]
2020-02-07 v1.2 draft
    [pcb.kicad_pcb, pcb.sch]
2020-02-07 v1.2 draft gerbers
    [pcb-B_Cu.gbl, pcb-B_Mask.gbs, pcb-B_Paste.gbp, pcb-B_SilkS.gbo, pcb-Edge_Cuts.gm1, pcb-F_Cu.gtl, pcb-F_Mask.gts, pcb-F_Paste.gtp]
2020-02-07 pcb as purchased
2020-02-08 pngs and bob as-ordered
    [BOM.csv, BOM.xlsx]
2021-01-18 add 2*3 100 mil header to BOM
    [BOM.csv, BOM.xlsx, pcb.sch]
2021-04-16 change resistor for charging mode
