scottalmond/EletronicEgg/(notices)

Notices in the files:
pcb/draft_1-2/pcb/pcb.kicad_pcb:
License: CC BY 4.0
